phuzzykins/Ackbar/README.md

# Ackbar's Snack Bar

A new rat trap design
