phuzzykins/Ackbar/Ackbar BOM.xlsx

Description | QTY | COST EA | COST EX | URL
PETG Plastic (KG) | 1.5 | 19.79 | 29.685 | https://www.amazon.com/dp/B0BN4Y1G2S/
ABS Pipe 4" Diameter 380mm length | 1 | 8.81 | 8.81 | https://www.homedepot.com/p/VPC-4-in-x-10-ft-ABS-Cell-Core-Pipe-29-410HD/309282462
ESP32-S3 Pico | 1 | 10.99 | 10.99 | https://www.waveshare.com/product/mcu-tools/development-boards/esp32/esp32-s3-pico.htm
E-Ink 1.54 | 1 | 11.99 | 11.99 | https://www.waveshare.com/product/displays/e-paper/epaper-3/1.54inch-e-paper-module.htm
TMC2209 | 1 | 3.75 | 3.75 | https://www.amazon.com/dp/B0C373SJLQ/
VL53L0X | 1 | 4.25 | 4.25 | https://www.amazon.com/dp/B08V8SKKZ4
Hall Sensor | 1 | 0.75 | 0.75 | https://www.amazon.com/dp/B07JMQFY6G
Buck Regulator | 1 | 1.2 | 1.2 | https://www.amazon.com/dp/B08JZ5FVLC
Barrel Jack | 1 | 1.37 | 1.37 | https://www.amazon.com/dp/B091PS6XQ4
USB C Panel Mount | 1 | 9.49 | 9.49 | https://www.amazon.com/dp/B08HS6X44P
NEMA17 Stepper | 1 | 9.99 | 9.99 | https://www.amazon.com/dp/B0B93LJPG2
380mm 2020 Extrusion | 4 | 3.12 | 12.48 | https://www.amazon.com/dp/B08KQCHTZL
M2.5 x 6mm Socket Cap | 2 | 0.0759 | 0.1518 | https://www.amazon.com/dp/B01H2108EW
M3 x 5mm Socket Cap | 10 | 0.0788 | 0.788 | https://www.amazon.com/dp/B08B1T4HHP
M3 x 20mm Socket Cap | 6 | 0.0939 | 0.5634 | https://www.amazon.com/Socket-Screws-Metric-Stainless-Machine/dp/B0BM5L4NLF
M5 x 10mm Button Head | 12 | 0.0939 | 1.1268 | https://www.amazon.com/dp/B0BKZ7WZFR
M5 x 20mm SS Flat Head | 8 | 0.1898 | 1.5184 | https://www.amazon.com/dp/B08P6F2KZ8
M5 x 14mm Thumb Screw | 4 | 0.333 | 1.332 | https://www.amazon.com/dp/B0BH1Z541L
M5 2020 T-Nut | 12 | 0.1598 | 1.9176 | https://www.amazon.com/dp/B01GCDG2QO
M3 Heat Set Insert | 12 | 0.11 | 1.32 | https://www.amazon.com/dp/B09ZNXRD2H
M5 Heat Set Insert | 12 | 0.26 | 3.12 | https://www.amazon.com/dp/B09ZP5QMZP
 |  |  | 116.593
