phuzzykins/Ackbar/STLs/Motor Mount.stl

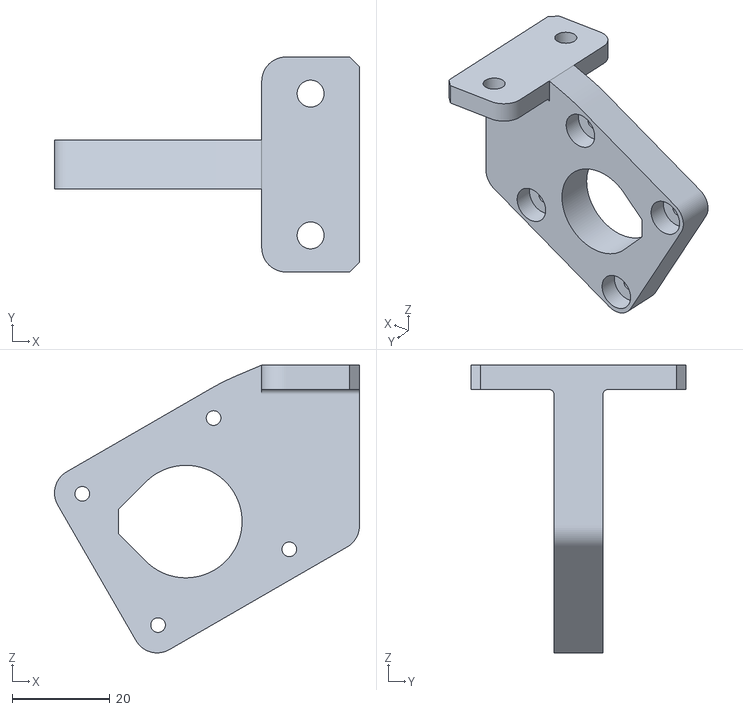
[picture p1: CAD file, 2023-11-30]
STLs/Motor Mount.stl
62.4 x 44.0 x 58.9
