phuzzykins/Ackbar/STLs/Chute Rear End Cap.stl

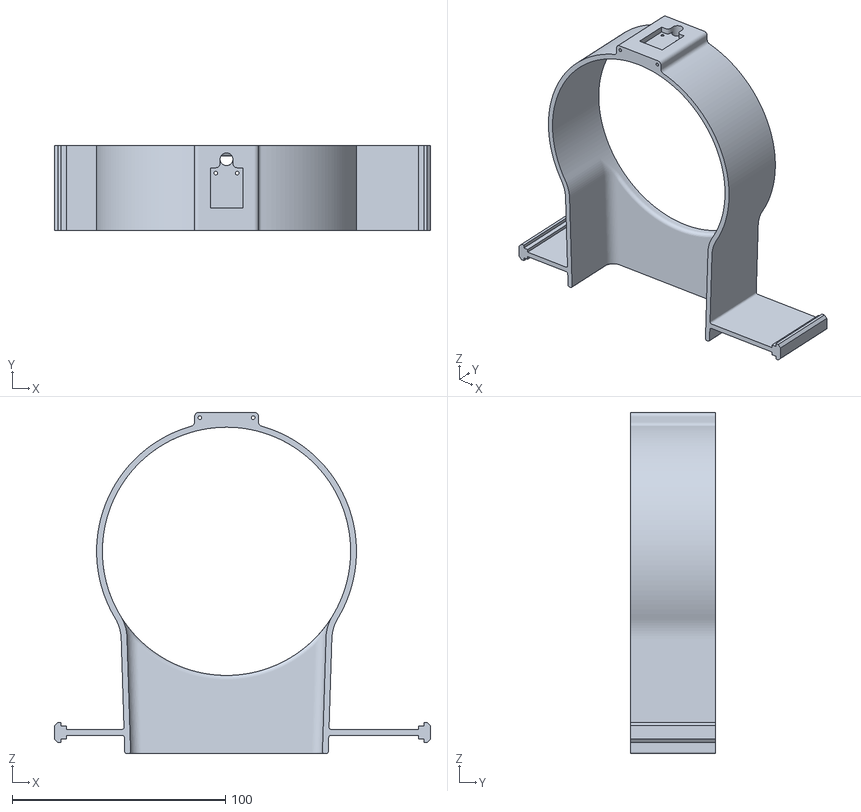
[picture p2: CAD file, 2023-11-10]
STLs/Chute Rear End Cap.stl
176.5 x 40.0 x 160.2
