phuzzykins/Ackbar/STLs/Chute Section Plain.stl

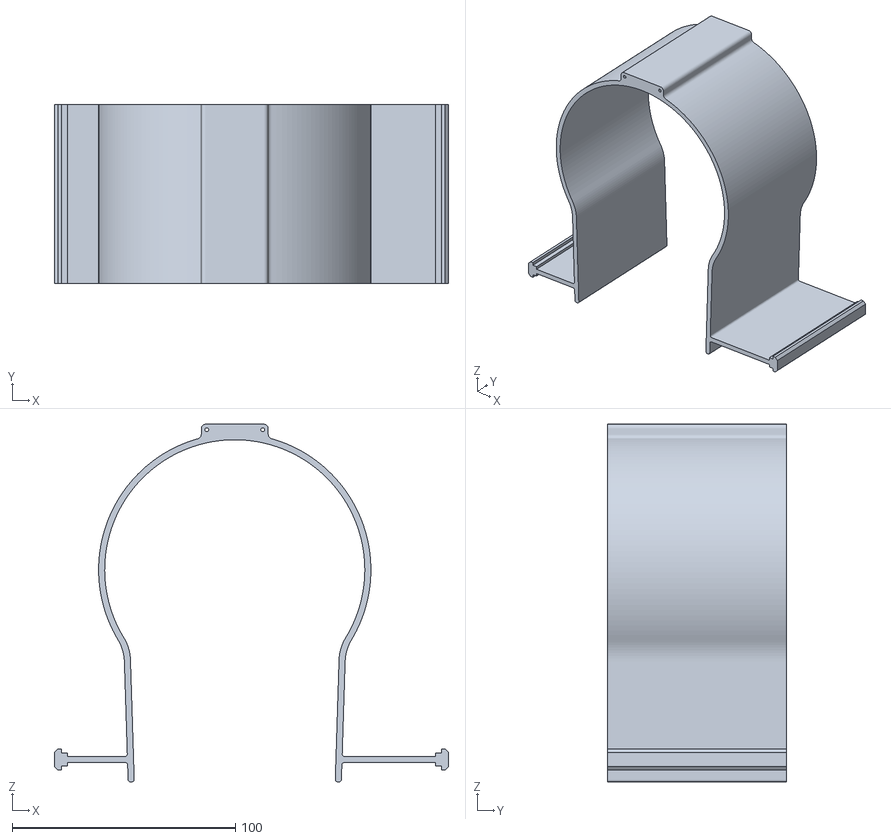
[picture p3: CAD file, 2023-11-10]
STLs/Chute Section Plain.stl
176.5 x 80.0 x 160.2
