phuzzykins/Ackbar/STLs/Rear Bezel.stl

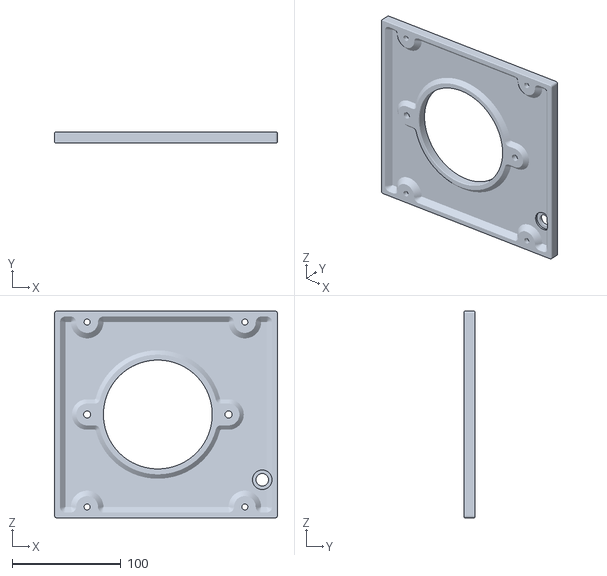
[picture p4: CAD file, 2023-11-06]
STLs/Rear Bezel.stl
205.0 x 10.0 x 190.0
