phuzzykins/Ackbar/STLs/Front Bezel.stl

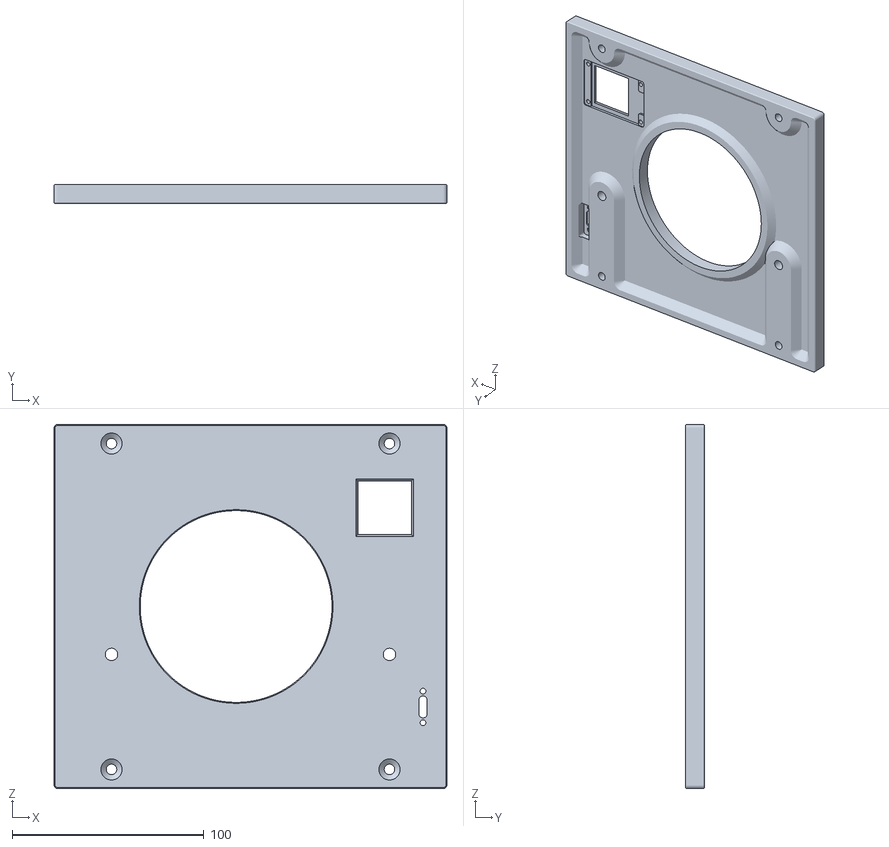
[picture p5: CAD file, 2023-11-06]
STLs/Front Bezel.stl
205.0 x 10.0 x 190.0
