phuzzykins/Ackbar/STLs/Plank.stl

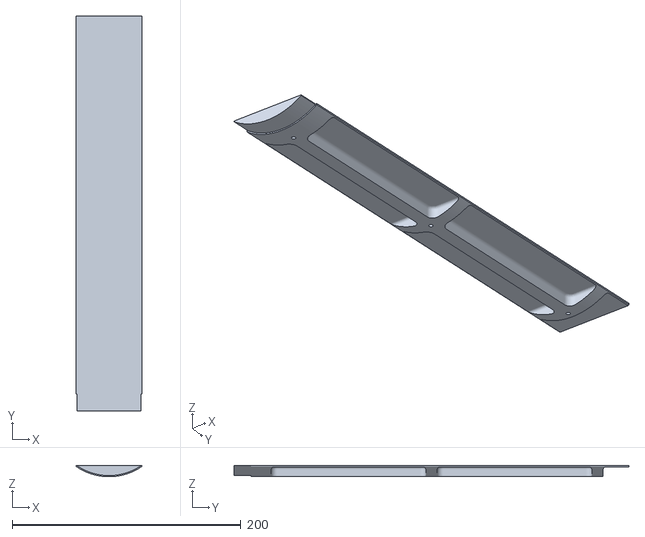
[picture p6: CAD file, 2023-11-06]
STLs/Plank.stl
57.5 x 345.0 x 10.0
