phuzzykins/Ackbar/STLs/Ladder Section v7.stl

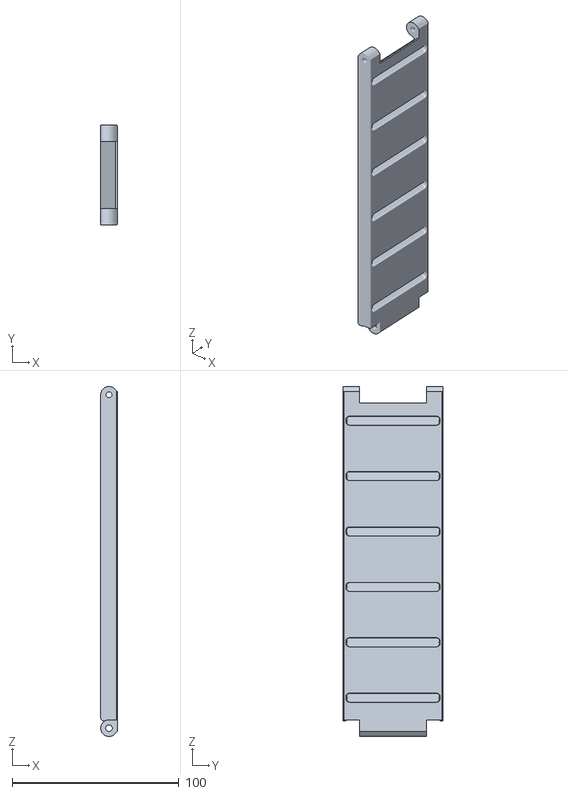
[picture p7: CAD file, 2023-11-06]
STLs/Ladder Section v7.stl
10.0 x 60.0 x 210.0
