phuzzykins/Ackbar/STLs/Drive Gear.stl

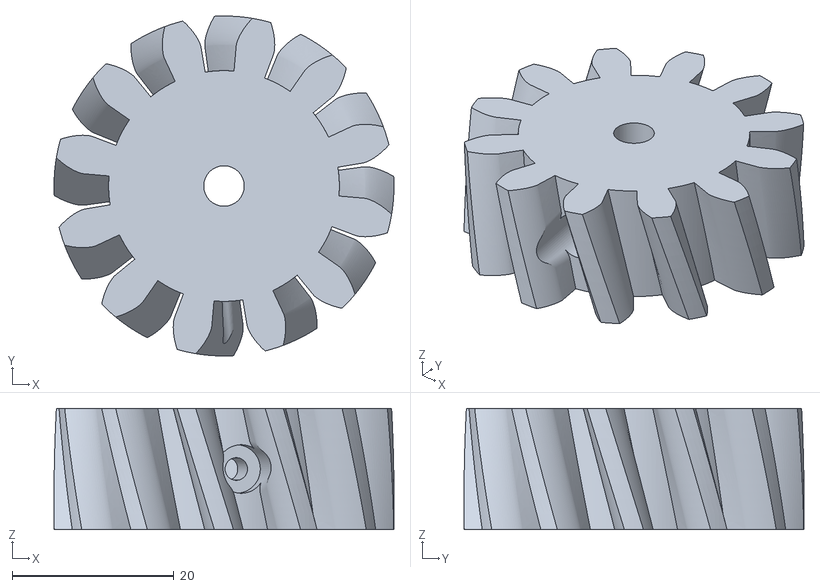
[picture p8: CAD file, 2023-11-06]
STLs/Drive Gear.stl
42.0 x 42.0 x 15.0
