phuzzykins/Ackbar/STLs/Ladder Mount.stl

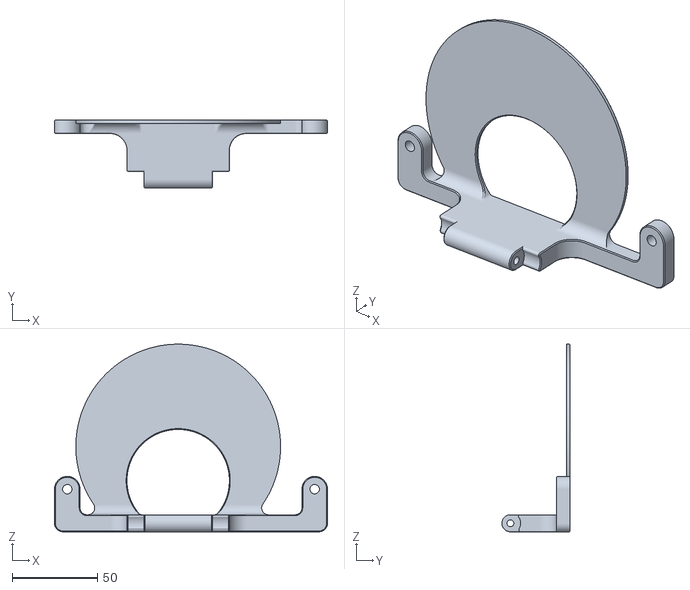
[picture p9: CAD file, 2023-11-06]
STLs/Ladder Mount.stl
160.0 x 40.0 x 110.0
