phuzzykins/Ackbar/STLs/Toob.stl

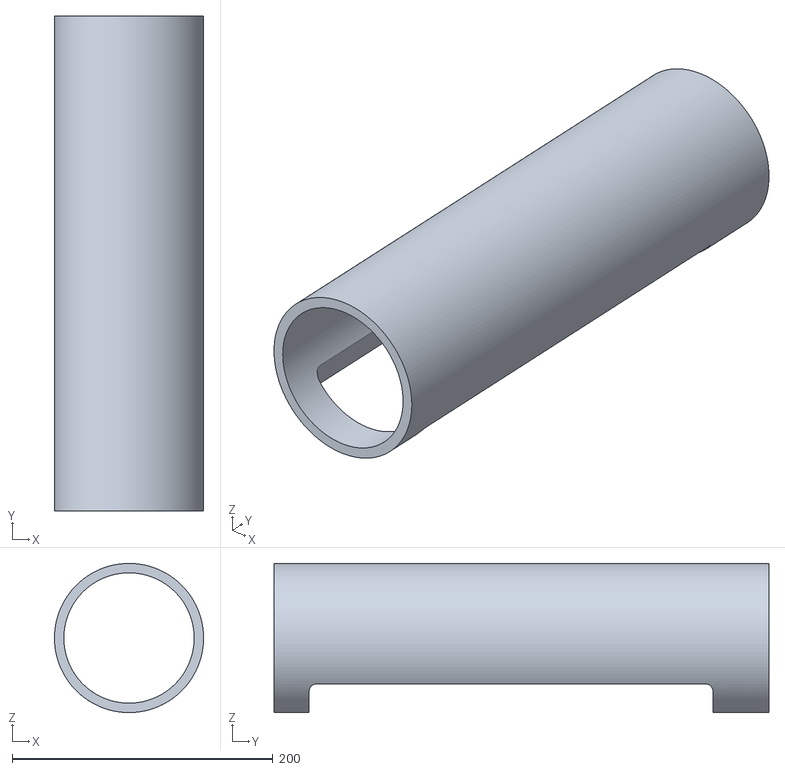
[picture p10: CAD file, 2023-11-06]
STLs/Toob.stl
114.5 x 380.0 x 114.5
