phuzzykins/Ackbar/STLs/PCB Mount.stl

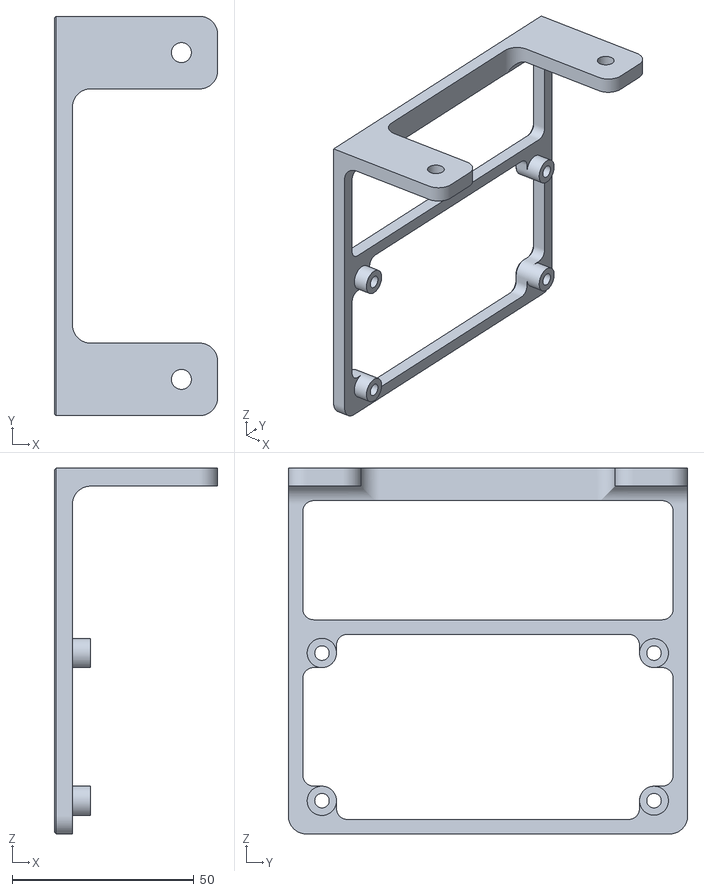
[picture p11: CAD file, 2023-11-06]
STLs/PCB Mount.stl
45.0 x 110.0 x 100.8
