phuzzykins/Ackbar/STLs/1mm Shim.stl

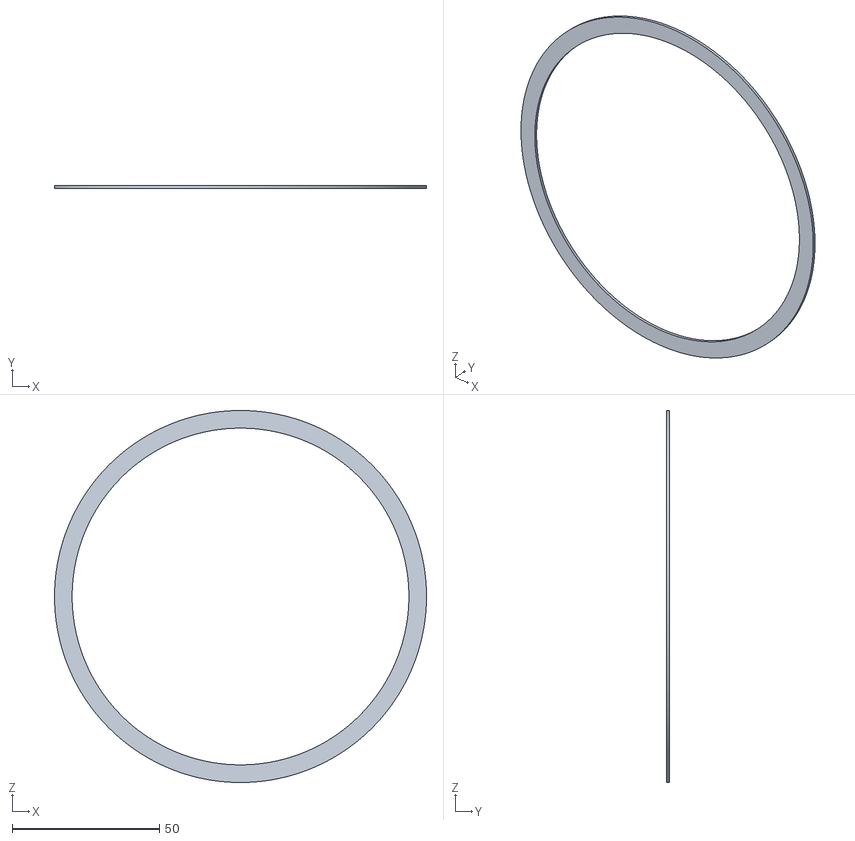
[picture p12: CAD file, 2023-11-06]
STLs/1mm Shim.stl
126.5 x 1.00 x 126.5
