phuzzykins/Ackbar/STLs/Bait Holder.stl

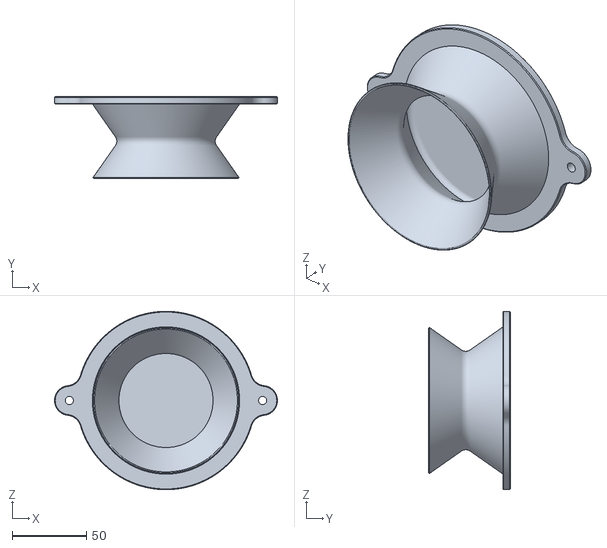
[picture p13: CAD file, 2023-11-06]
STLs/Bait Holder.stl
150.0 x 55.0 x 120.0
