phuzzykins/Ackbar/(list of files, cad)

Other CAD files:
STLs/Chute Front End Cap.stl
STLs/Chute Section With Sensor.stl
