phuzzykins/Ackbar/(list of files, drawings)

Other design files:
Board/freerouting.dsn
