phuzzykins/Ackbar/Board/Ackbar.kicad_pcb

## KiCad design Board/Ackbar.kicad_pcb (2023-11-13)

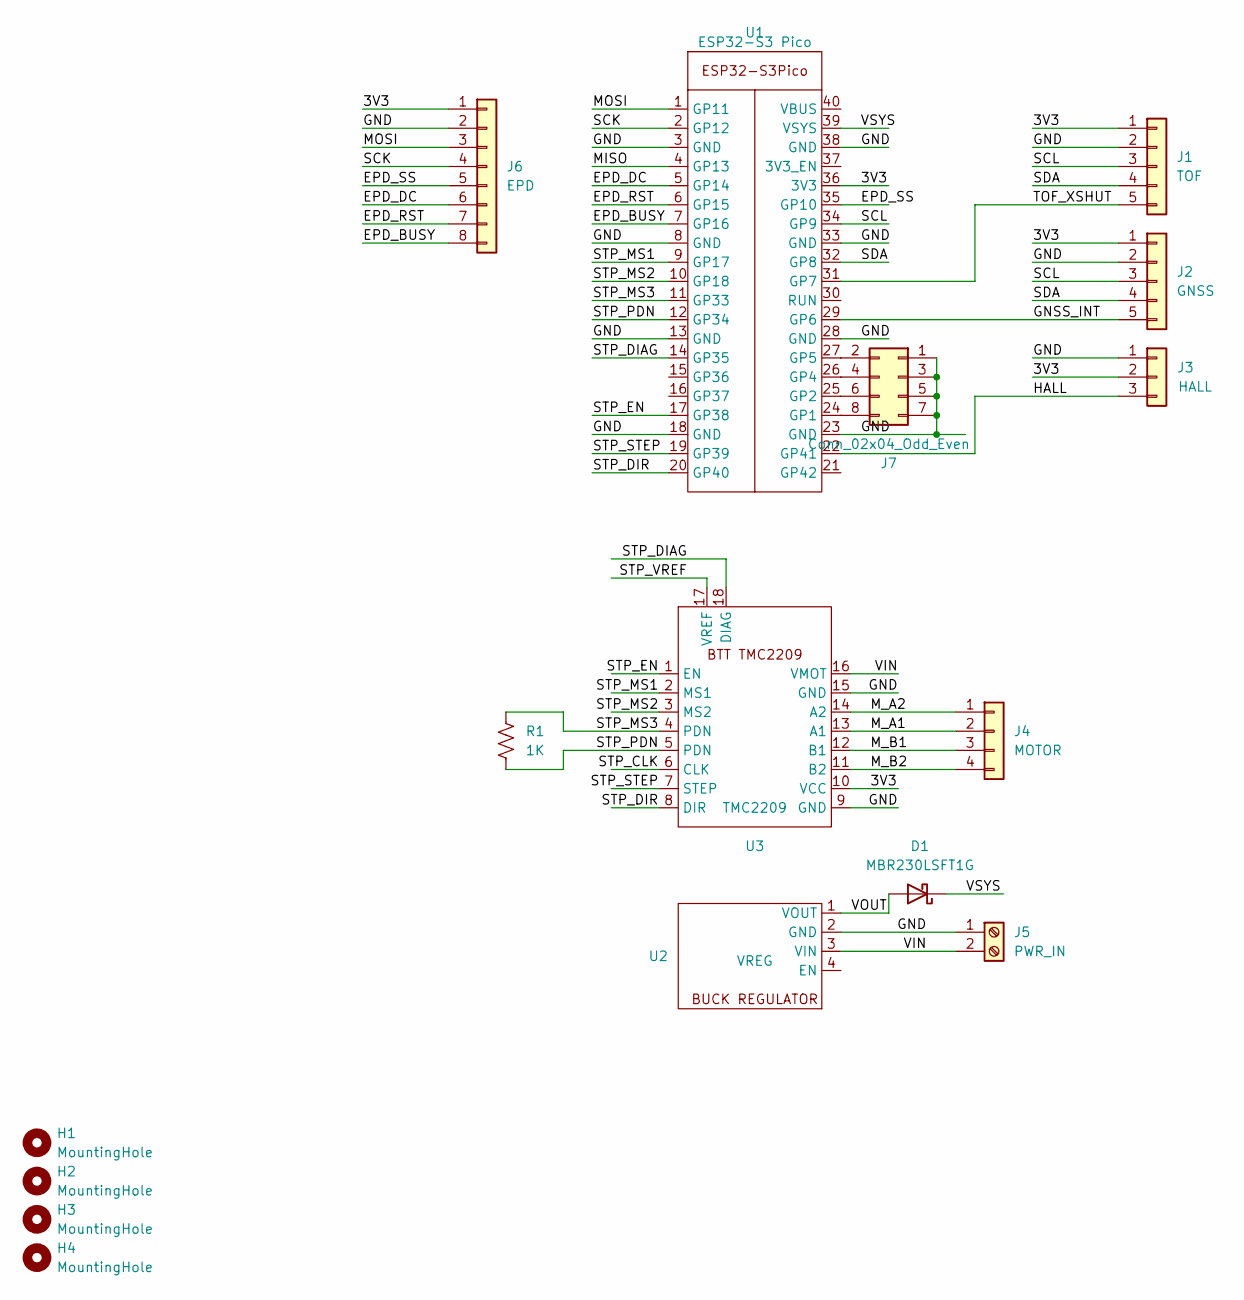
[picture p14: schematic Ackbar.kicad_sch]

Parts:
D1: MBR230LSFT1G; D_SOD-123
H1, H2, H3, H4: MountingHole; MountingHole_3.2mm_M3
J1: TOF; 1X05
J2: GNSS; 1X05
J3: HALL; 1X03
J4: MOTOR; 1X04
J5: PWR_IN; TerminalBlock_4Ucon_1x02_P3.50mm_Horizontal
J6: EPD; 1X08
J7: Conn_02x04_Odd_Even; PinSocket_2x04_P2.54mm_Vertical
R1: 1K; R_0805_2012Metric_Pad1.20x1.40mm_HandSolder
U1: ESP32-S3 Pico; Waveshare ESP32-S3 Pico
U2: VREG; Buck Regulator
U3: TMC2209; BTT TMC2209

Connections:
/3V3: J1.1, J2.1, J3.2, J6.1, U1.36 (3V3), U3.10 (VCC)
/EPD_BUSY: J6.8, U1.7 (GP16)
/EPD_DC: J6.6, U1.5 (GP14)
/EPD_RST: J6.7, U1.6 (GP15)
/EPD_SS: J6.5, U1.35 (GP10)
/GND: J1.2, J2.2, J3.1, J5.1, J6.2, J7.1, J7.3, J7.5, J7.7, U1.3 (GND), U1.8 (GND), U1.13 (GND), U1.18 (GND), U1.23 (GND), U1.28 (GND), U1.33 (GND), U1.38 (GND), U2.2 (GND), U3.9 (GND), U3.15 (GND)
/GNSS_INT: J2.5, U1.29 (GP6)
/HALL: J3.3, U1.22 (GP41)
/MISO: U1.4 (GP13)
/MOSI: J6.3, U1.1 (GP11)
/M_A1: J4.2, U3.13 (A1)
/M_A2: J4.1, U3.14 (A2)
/M_B1: J4.3, U3.12 (B1)
/M_B2: J4.4, U3.11 (B2)
/SCK: J6.4, U1.2 (GP12)
/SCL: J1.3, J2.3, U1.34 (GP9)
/SDA: J1.4, J2.4, U1.32 (GP8)
/STP_CLK: U3.6 (CLK)
/STP_DIAG: U1.14 (GP35), U3.18 (DIAG)
/STP_DIR: U1.20 (GP40), U3.8 (DIR)
/STP_EN: U1.17 (GP38), U3.1 (EN)
/STP_MS1: U1.9 (GP17), U3.2 (MS1)
/STP_MS2: U1.10 (GP18), U3.3 (MS2)
/STP_MS3: R1.1, U1.11 (GP33), U3.4 (PDN)
/STP_PDN: R1.2, U1.12 (GP34), U3.5 (PDN)
/STP_STEP: U1.19 (GP39), U3.7 (STEP)
/STP_VREF: U3.17 (VREF)
/TOF_XSHUT: J1.5, U1.31 (GP7)
/VIN: J5.2, U2.3 (VIN), U3.16 (VMOT)
/VOUT: D1.2 (A), U2.1 (VOUT)
/VSYS: D1.1 (K), U1.39 (VSYS)
unnamed: J7.2, U1.27 (GP5)
unnamed: J7.4, U1.26 (GP4)
unnamed: J7.6, U1.25 (GP2)
unnamed: J7.8, U1.24 (GP1)

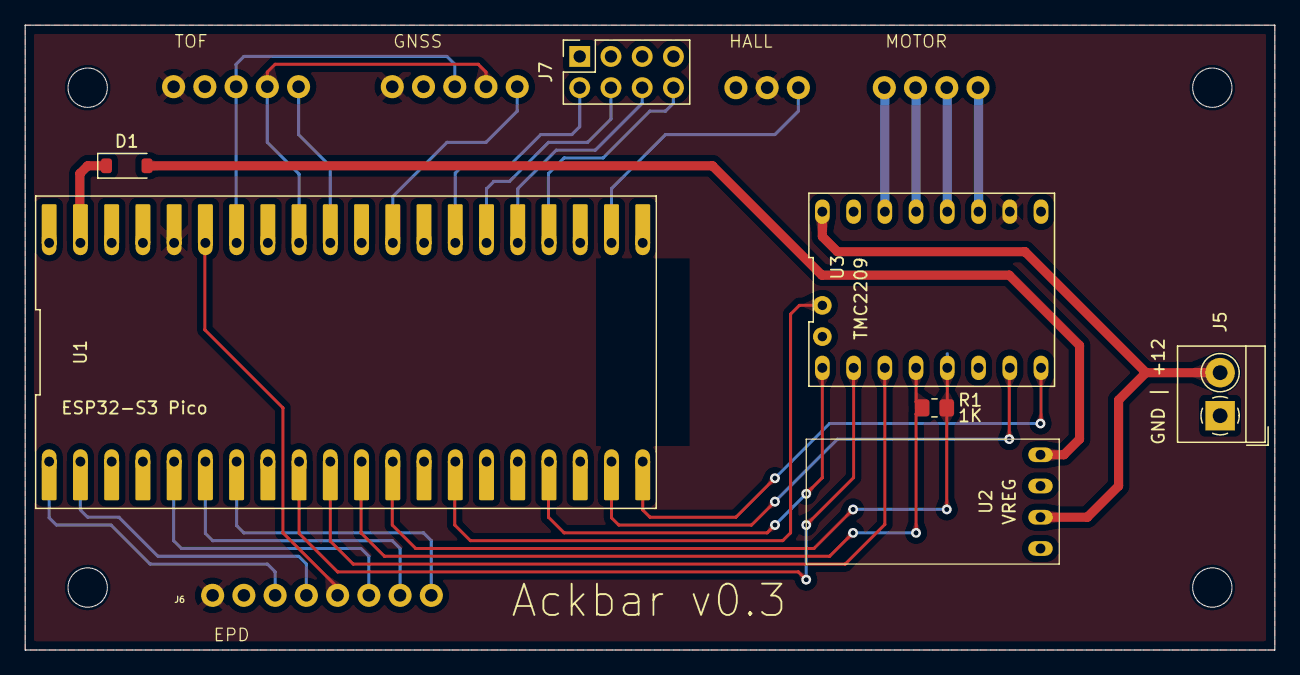
[picture p15: board Ackbar.kicad_pcb from above]

Board: 2 copper layers, 101.6 x 50.8 mm, 16 parts (0 on the bottom side), 32 nets.
