phuzzykins/Ackbar/AckbarFirmware/AckbarComponent.h

#ifndef __ACKBAR_COMPONENT_H__
#define __ACKBAR_COMPONENT_H__

#include "AckbarConfiguration.h"

class AckbarComponent
{
  public:
    virtual char * name() = 0;
    virtual bool begin() = 0;
    virtual bool calibrate() = 0;

    void setConfiguration(AckbarConfiguration * c)
    {
      configuration = c;
    };

  protected:
    AckbarConfiguration * configuration;
};


#endif // __ACKBAR_COMPONENT_H__
