phuzzykins/Ackbar/(commit log)

2023-09-18 Cleanup ground fill
    [Ackbar.kicad_pcb]
2023-09-18 Clean up ESP32 footprint to merge pads properly
    [Ackbar.kicad_pcb]
2023-09-18 regenerate fills
    [Ackbar.kicad_pcb]
2023-09-19 Adding BOM
    [Ackbar BOM.xlsx]
2023-09-19 update bom
    [Ackbar BOM.xlsx]
2023-09-20 add inverter to schematic
    [Ackbar.kicad_pcb, Ackbar.kicad_sch]
2023-09-20 Larger footprint for inverter
    [Ackbar.kicad_pcb, Ackbar.kicad_sch]
2023-09-21 cleanup vreg inhibit
    [Ackbar.kicad_pcb, Ackbar.kicad_sch]
2023-09-22 Re-route PCB and move USB C connector to board edge
    [Ackbar.kicad_pcb]
2023-09-22 WIP of firmware refactoring
    [Ackbar.kicad_pcb, Ackbar.kicad_sch]
2023-09-24 Move events to their own thread
2023-09-24 Exclude kicad library backups
2023-09-24 Switch to native esp32 / freeRTOS task API to pin event thread to opposite core of Arduino
2023-09-24 Whoops, event thread needs more stack space when wifi is required
2023-09-24 Prep work for further ePaper display development - add a few more events, and get the blocking device writes into the event thread
2023-09-24 Add synchronous delivery option for event consumers to avoid LED updates getting stuck behind ePaper and network operations
    [AckbarEventConsumer.h, AckbarEventService.cpp, AckbarStatusLED.cpp, AckbarStatusLED.h]
2023-09-24 Add pullup resistor to vreg enable
    [Ackbar.kicad_pcb, Ackbar.kicad_sch]
2023-09-24 Okay, you win, we're using the onboard regulator
    [Ackbar.kicad_pcb, Ackbar.kicad_sch]
2023-09-24 Replace missing mounting holes
    [Ackbar.kicad_pcb, Ackbar.kicad_sch]
2023-09-25 Switch to GxEPD2 ePaper driver as the Adafruit one is not well maintained
2023-09-29 Switch to HTTPS for notifications, and keep track of notifications we were unable to send.
2023-10-07 Add error handling to begin and calibrate methods
    [Ackbar.cpp, AckbarBLE.cpp, AckbarBLE.h, AckbarBarrelMechanism.cpp, AckbarBarrelMechanism.h, AckbarComponent.h, AckbarDisplay.cpp, AckbarDisplay.h]
2023-10-07 Push errors to the e-ink display
    [Ackbar.cpp, AckbarDisplay.cpp, AckbarDisplay.h, AckbarEvent.h, AckbarEventService.cpp]
2023-10-26 Add delay time
    [Ackbar.kicad_pcb, freerouting.dsn]
2023-11-06 Enjoy the STLs
    [1mm Shim.stl, Bait Holder.stl, Chute Front End Cap.stl, Chute Rear End Cap.stl, Chute Section Plain.stl, Chute Section With Sensor.stl, Drive Gear.stl, Front Bezel.stl]
2023-11-10 Modify the chute parts to slide into the t-slots rather than use fasteners
    [Ackbar BOM.xlsx, Chute Front End Cap.stl, Chute Rear End Cap.stl, Chute Section Plain.stl, Chute Section With Sensor.stl]
2023-11-13 Break out a few currently unused pins for config jumpers
    [Ackbar.kicad_pcb, Ackbar.kicad_sch]
2023-11-30 Add alignment dimples to the planetary bearings, and teardrop the motor boss cutout
    [Motor Mount.stl]
